sadekbaroudi/STeMCell/pinout.markdown

---
layout: default
title: Pinout
permalink: /pinout/
has_children: false
nav_order: 5
---

# Pinout

| Arduino | Pro Micro | STeMCell v1.0.0 | STeMCell v1.0.1 |
|---|---|---|---|
| 1 | D3 | A2 | A2 |
| 0 | D2 | A3 | A3 |
| | | | |
| 2 | D1 | B7 | B7 |
| 3/A6 | D0 | B6 | B6 |
| 4 | D4 | A15 | A15 |
| 5 | C6 | B3 | B3 |
| 6/A7 | D7 | B4 | B4 |
| 7 | E6 | B5 | B5 |
| 8/A8 | B4 | B8 | B8 |
| 9/A9 | B5 | B9 | B9 |
| | | | |
| 21/A3 | F4 | B10 | B10 |
| 20/A2 | F5 | B2 | B2 |
| 19/A1 | F6 | B1 | B1 |
| 18/A0 | F7 | B0 | B0 |
| 15 | B1 | A7 | A5 |
| 14 | B3 | A6 | A6 |
| 16 | B2 | A5 | A7 |
| 10/A10  | B6 | A4 | A4 |

#### Note:
Pins A5 and A7 has been swapped in v1.0.1 for SPI pins compatibility
