sadekbaroudi/STeMCell/(commit log)

2022-04-27 updated to use type-c-31-m-12, since it's more commonly available
    [stemcell.kicad_pcb, stemcell.kicad_sch]
2022-10-14 added pre-soldered jumpers on the N position, can be cut with razor blade to remove
    [stemcell.kicad_pcb, stemcell.kicad_sch]
